jayriihi/WeatherStations/Installation guide/A5F87E7E-C54A-4EF5-8C4A-D947D573DE3A.jpeg

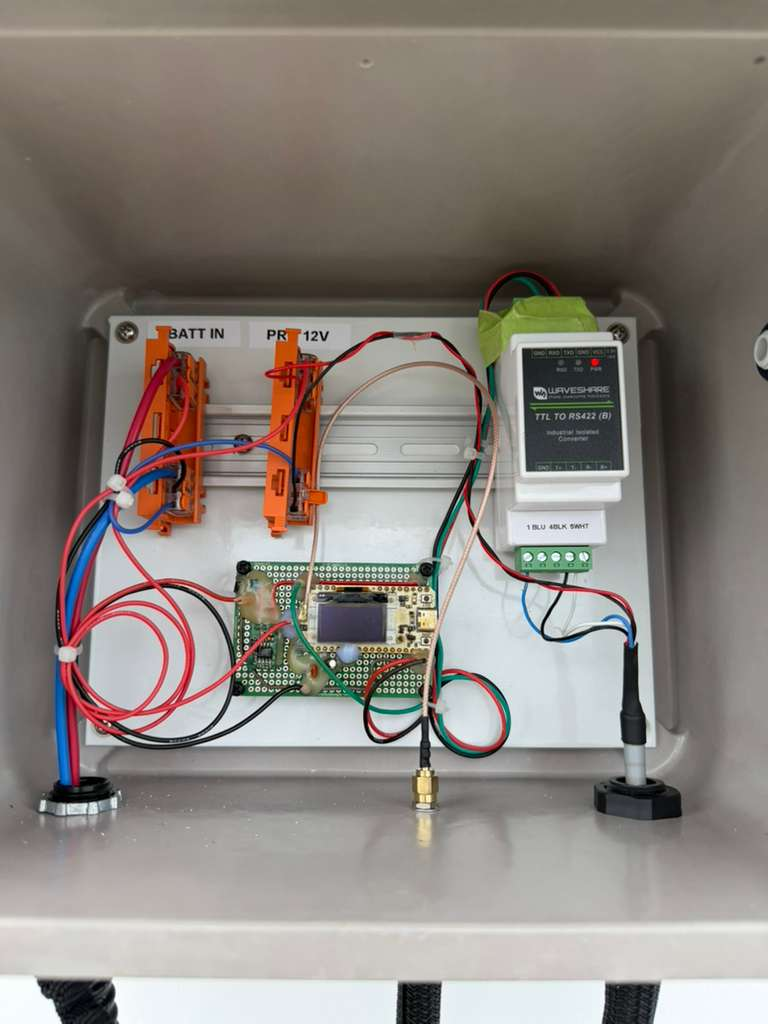
Installation guide/A5F87E7E-C54A-4EF5-8C4A-D947D573DE3A.jpeg
