jayriihi/WeatherStations/Installation guide/C7C500A0-B130-4A4E-9C59-5100DFB371AE_1_105_c.jpeg

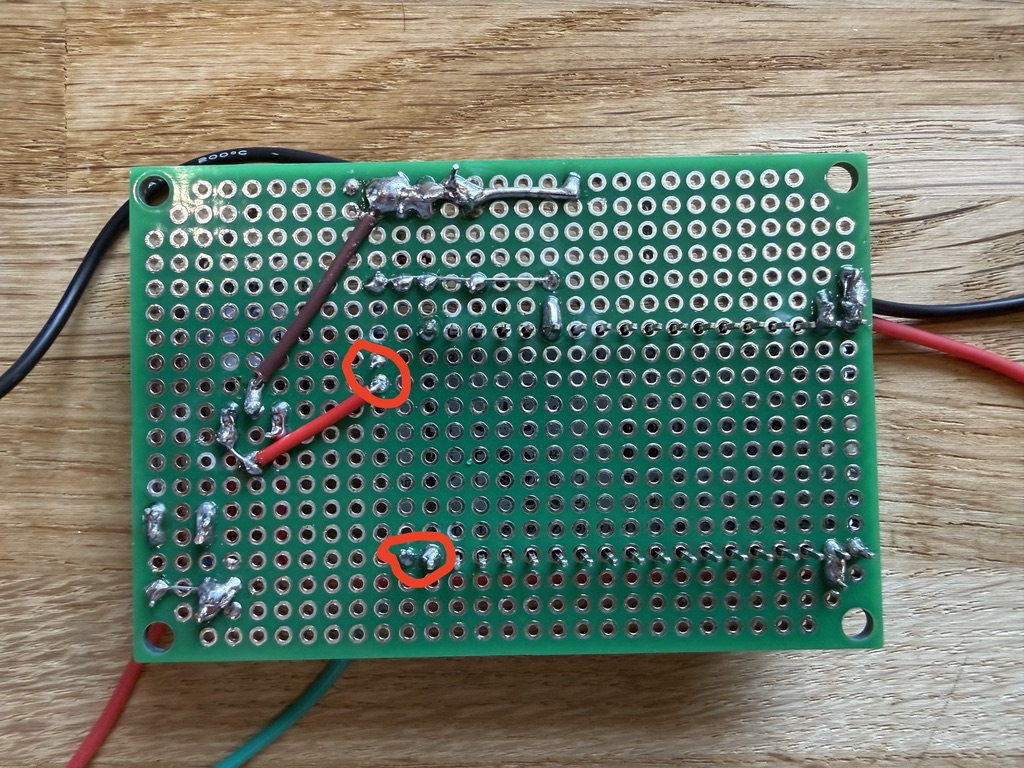
Installation guide/C7C500A0-B130-4A4E-9C59-5100DFB371AE_1_105_c.jpeg
