jayriihi/WeatherStations/Installation guide/0D3FA8E5-6161-42CE-9A30-51A0F75B8781_1_105_c.jpeg

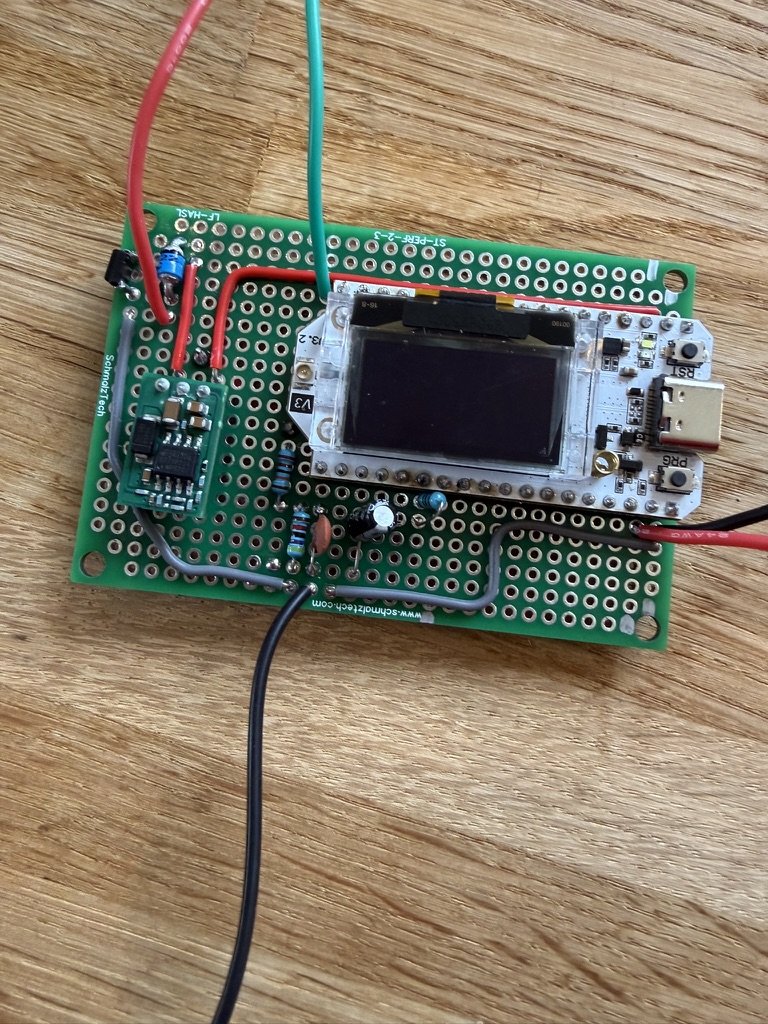
Installation guide/0D3FA8E5-6161-42CE-9A30-51A0F75B8781_1_105_c.jpeg
