jayriihi/WeatherStations/Installation guide/7A51FE77-24B7-4E6C-A224-1E0F3C1EAE3B.jpeg

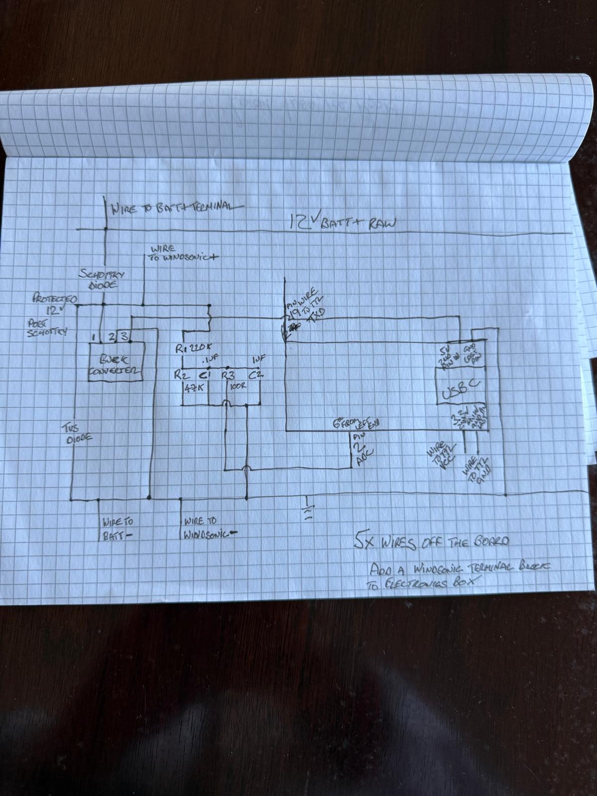
Installation guide/7A51FE77-24B7-4E6C-A224-1E0F3C1EAE3B.jpeg
