jayriihi/WeatherStations/Installation guide/47B4F61A-0BB7-46E7-BAB1-5AC1C1AD3077.jpeg

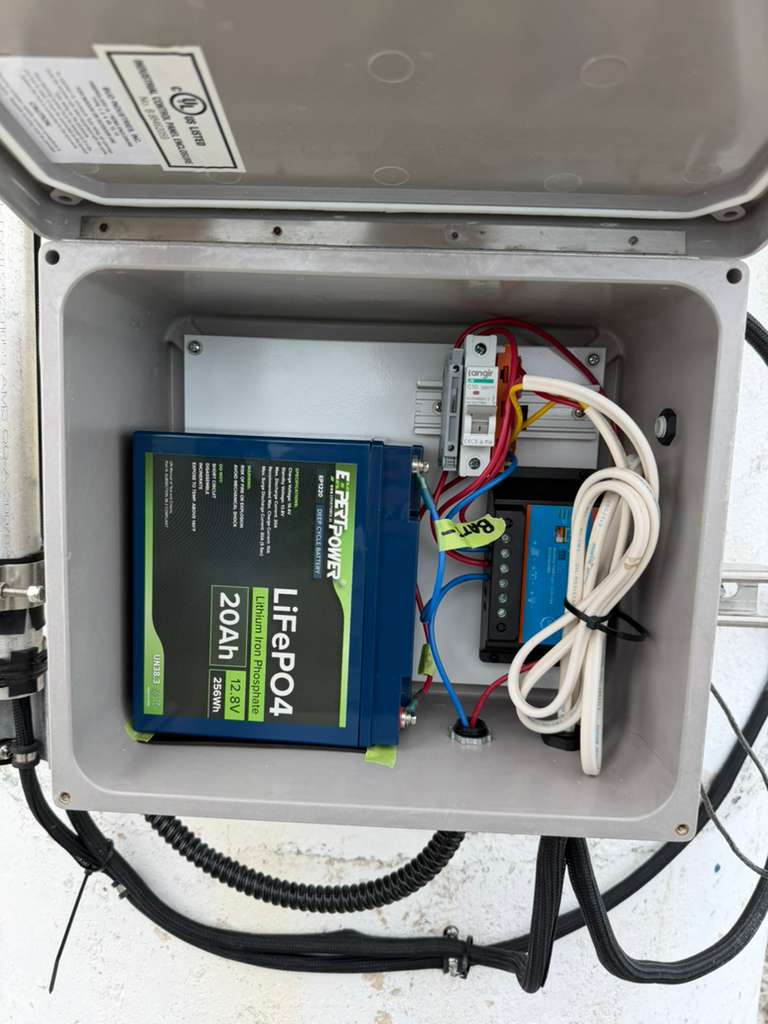
Installation guide/47B4F61A-0BB7-46E7-BAB1-5AC1C1AD3077.jpeg
