jayriihi/WeatherStations/Installation guide/923E344D-D00B-463C-AEA4-50D730EA1828.jpeg

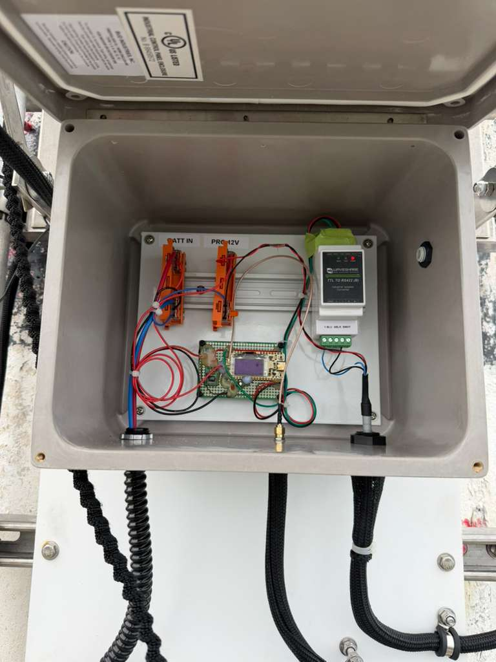
Installation guide/923E344D-D00B-463C-AEA4-50D730EA1828.jpeg
