jayriihi/WeatherStations/Installation guide/858491EE-78B4-45D4-884F-43A59CE96751.jpeg

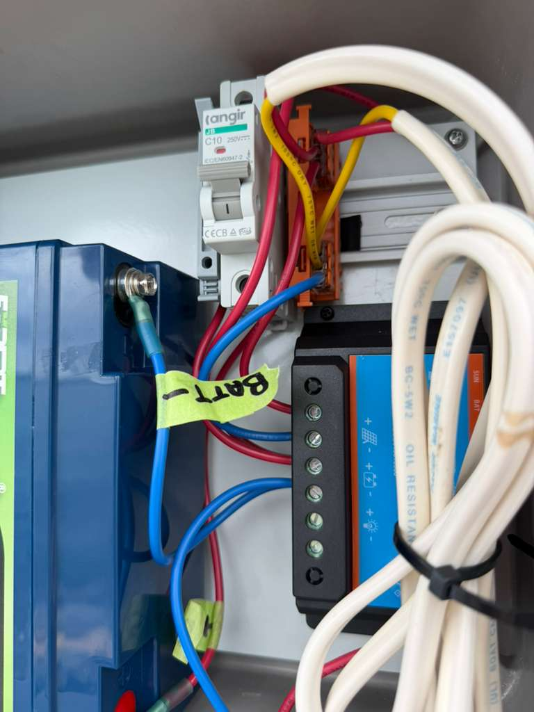
Installation guide/858491EE-78B4-45D4-884F-43A59CE96751.jpeg
