jayriihi/WeatherStations/Installation guide/4281659A-824E-446C-A85B-15BC7FDDD214_1_105_c.jpeg

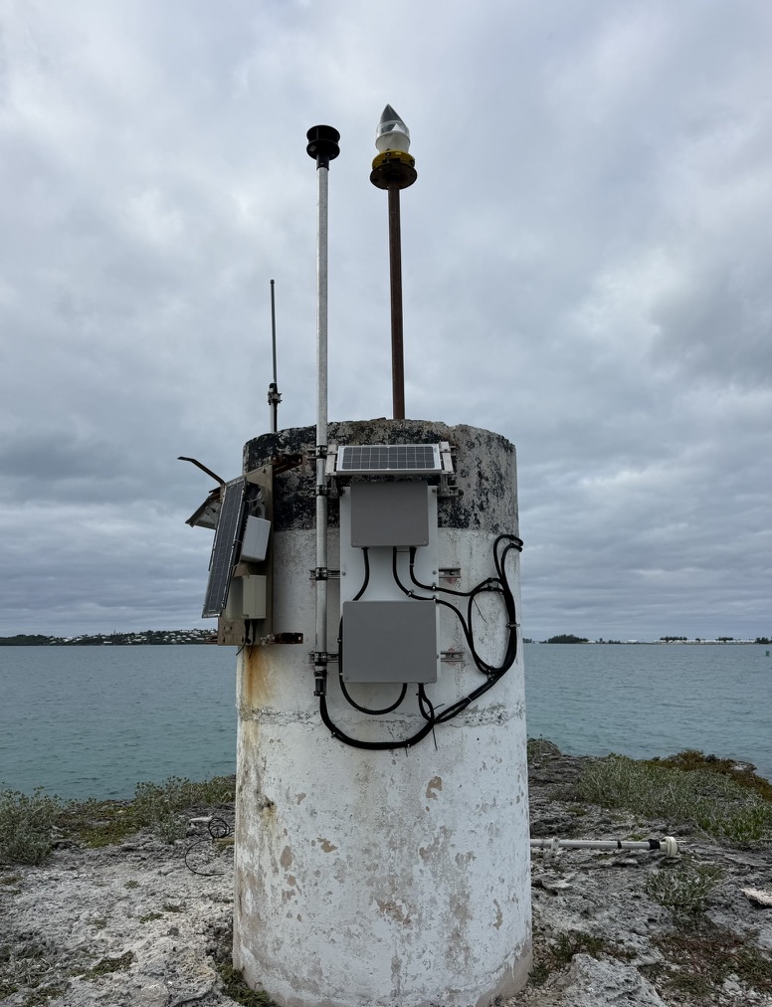
Installation guide/4281659A-824E-446C-A85B-15BC7FDDD214_1_105_c.jpeg
