jayriihi/WeatherStations/Installation guide/D3BEC081-118D-472E-A426-4E98B52E351B_1_105_c.jpeg

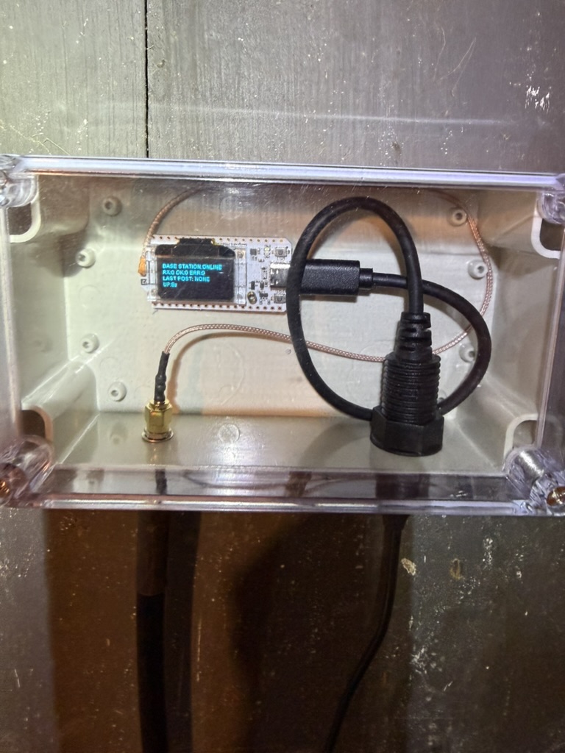
Installation guide/D3BEC081-118D-472E-A426-4E98B52E351B_1_105_c.jpeg
