jayriihi/WeatherStations/Installation guide/DDF8339E-81F4-4CF6-A731-107E2A5637DA_1_105_c.jpeg

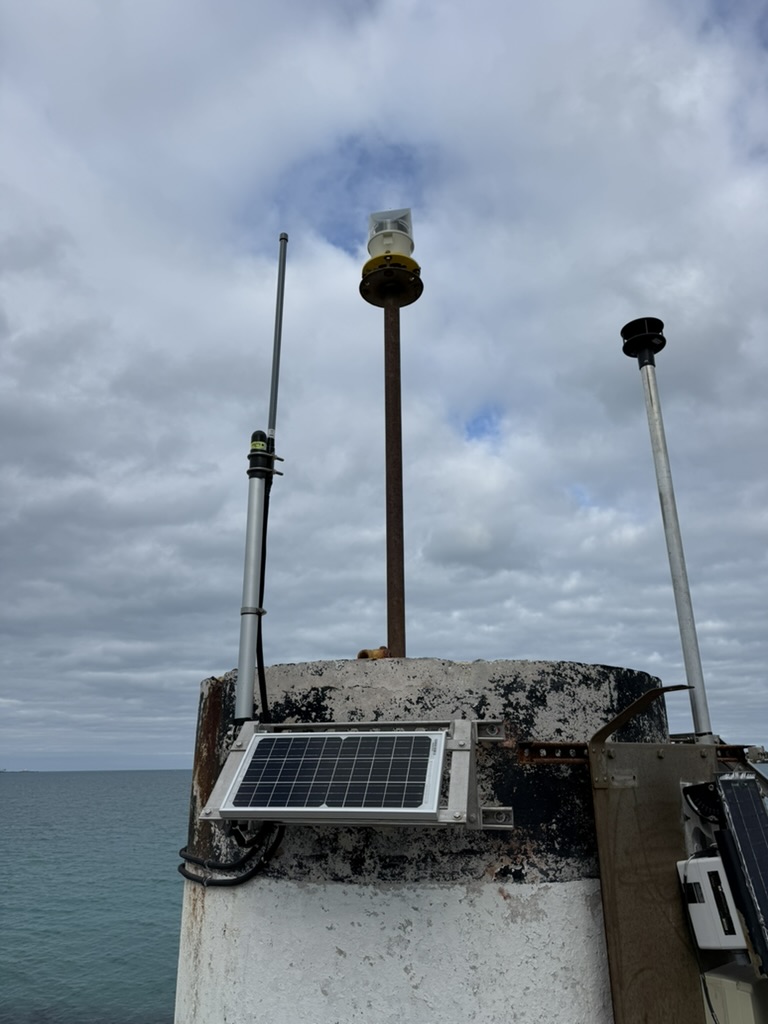
Installation guide/DDF8339E-81F4-4CF6-A731-107E2A5637DA_1_105_c.jpeg
