jayriihi/WeatherStations/Installation guide/FE76AD0C-E634-4722-B1B3-365DB53503B7.jpeg

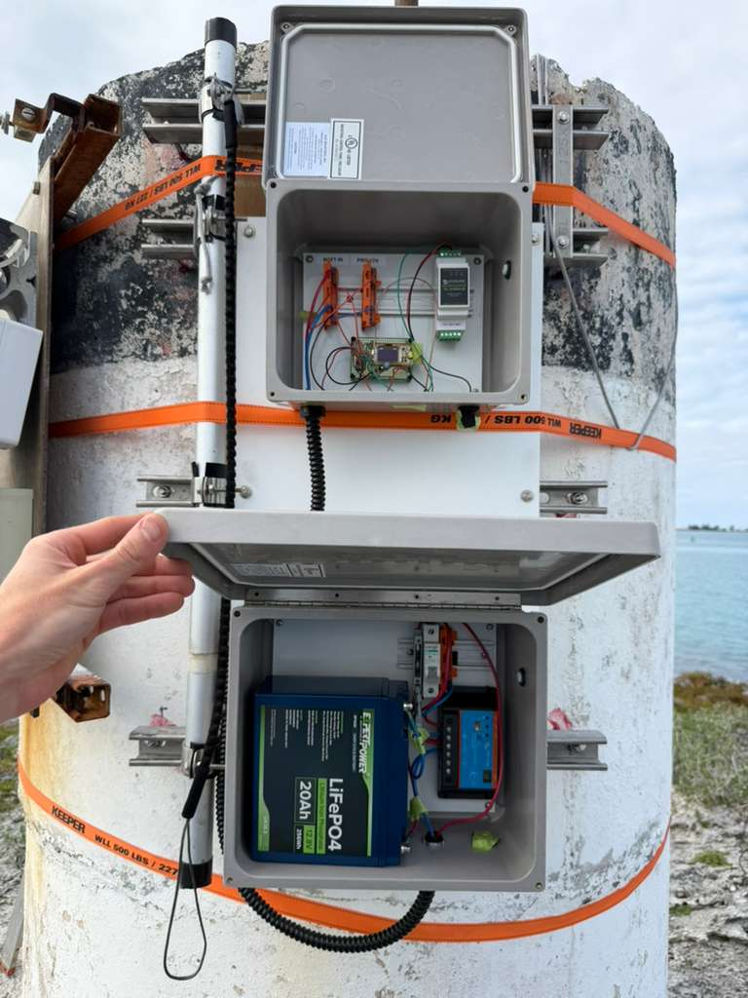
Installation guide/FE76AD0C-E634-4722-B1B3-365DB53503B7.jpeg
