jayriihi/WeatherStations/pearl-station/hardware/pearl-v2-assembly/provisional-layout/pearl_provisional_layout.png

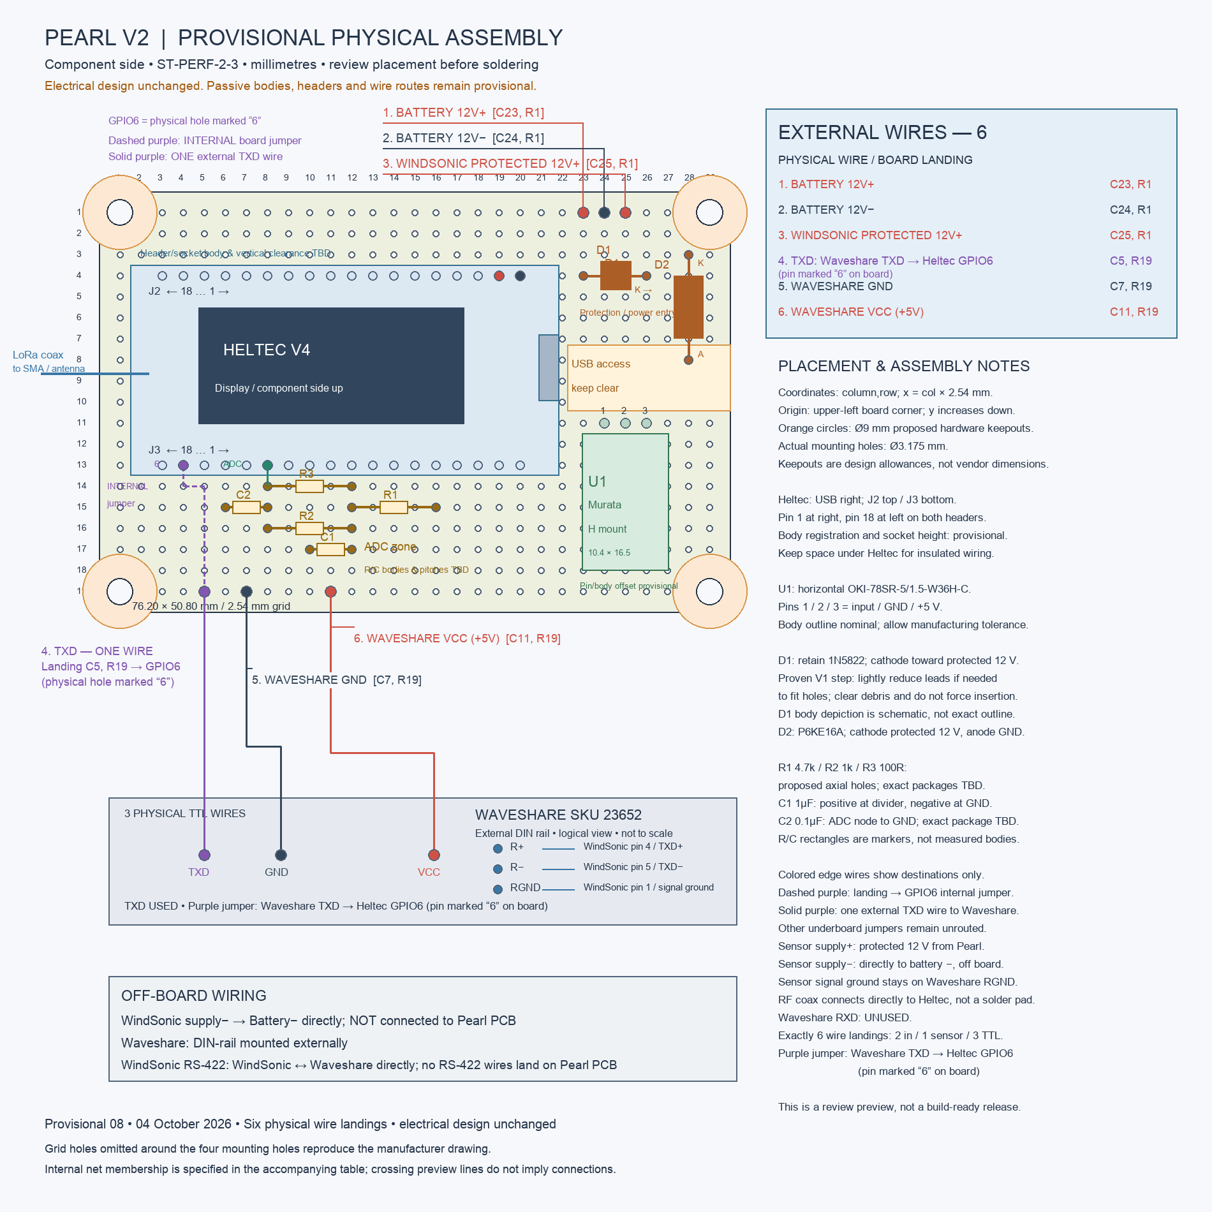
pearl-station/hardware/pearl-v2-assembly/provisional-layout/pearl_provisional_layout.png
