jayriihi/WeatherStations/pearl-station/hardware/pearl-v2-schematic/pearl_v2_final.sch

## KiCad design pearl-station/hardware/pearl-v2-schematic/pearl_v2_final.sch (2026-10-02)

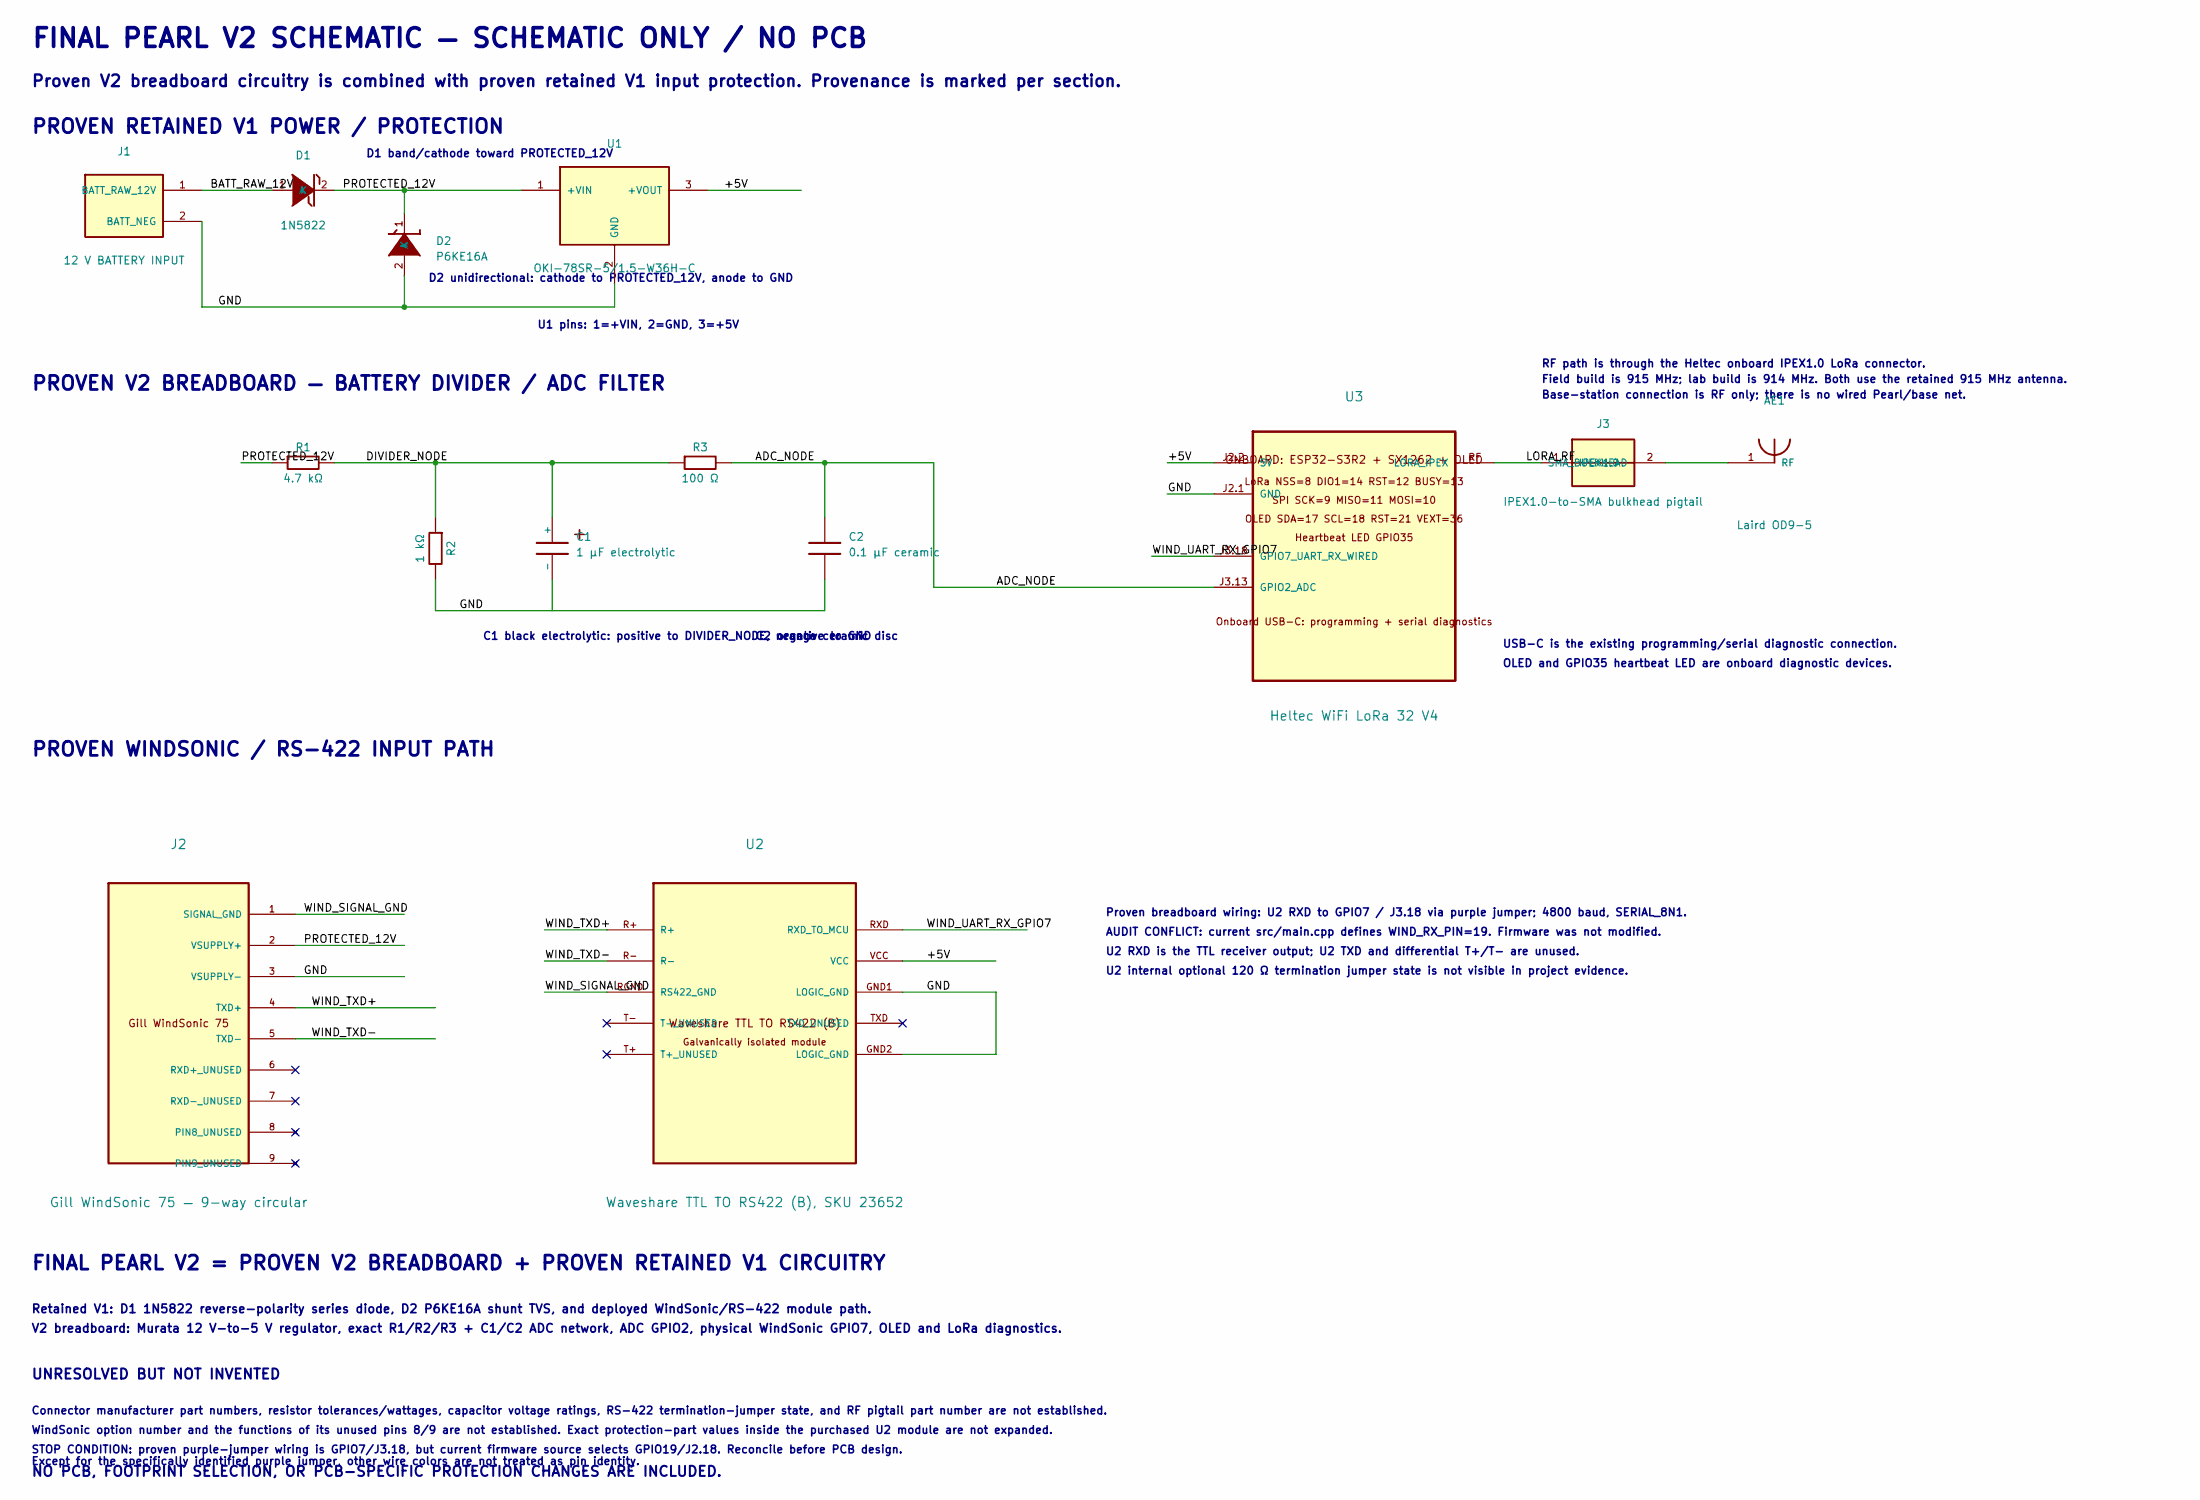
[picture p13: schematic pearl_v2_final.sch]

Parts:
AE1: Laird OD9-5
C1: 1 µF electrolytic
C2: 0.1 µF ceramic
D1: 1N5822
D2: P6KE16A
J1: 12 V BATTERY INPUT
J2: Gill WindSonic 75 — 9-way circular
J3: IPEX1.0-to-SMA bulkhead pigtail
R1: 4.7 kΩ
R2: 1 kΩ
R3: 100 Ω
U1: OKI-78SR-5/1.5-W36H-C
U2: Waveshare TTL TO RS422 (B), SKU 23652
U3: Heltec WiFi LoRa 32 V4

Connections:
+5V: U1.3 (+VOUT), U2.VCC, U3.J2.2 (5V)
ADC_NODE: C2.1, R3.2, U3.J3.13 (GPIO2_ADC)
BATT_RAW_12V: D1.1 (A), J1.1 (BATT_RAW_12V)
DIVIDER_NODE: C1.1 (+), R1.2, R2.1, R3.1
GND: C2.2, D2.2 (A), J1.2 (BATT_NEG), J2.3 (VSUPPLY-), R2.2, U1.2 (GND), U2.GND1 (LOGIC_GND), U2.GND2 (LOGIC_GND), U3.J2.1 (GND)
LORA_RF: J3.1 (IPEX1.0), U3.RF (LORA_IPEX)
unnamed: AE1.1, J3.2 (SMA_BULKHEAD)
PROTECTED_12V: D1.2 (K), D2.1 (K), J2.2 (VSUPPLY+), R1.1, U1.1 (+VIN)
WIND_SIGNAL_GND: J2.1 (SIGNAL_GND), U2.RGND (RS422_GND)
WIND_TXD+: J2.4 (TXD+), U2.R+
WIND_TXD-: J2.5 (TXD-), U2.R-
WIND_UART_RX_GPIO7: U2.RXD (RXD_TO_MCU), U3.J3.18 (GPIO7_UART_RX_WIRED)

Notes on the sheet:
FINAL PEARL V2 SCHEMATIC — SCHEMATIC ONLY / NO PCB
Proven V2 breadboard circuitry is combined with proven retained V1 input protection. Provenance is marked per section.
PROVEN RETAINED V1 POWER / PROTECTION
D1 band/cathode toward PROTECTED_12V
D2 unidirectional: cathode to PROTECTED_12V, anode to GND
U1 pins: 1=+VIN, 2=GND, 3=+5V
PROVEN V2 BREADBOARD — BATTERY DIVIDER / ADC FILTER
C1 black electrolytic: positive to DIVIDER_NODE, negative to GND
C2 orange ceramic disc
USB-C is the existing programming/serial diagnostic connection.
OLED and GPIO35 heartbeat LED are onboard diagnostic devices.
RF path is through the Heltec onboard IPEX1.0 LoRa connector.
Field build is 915 MHz; lab build is 914 MHz. Both use the retained 915 MHz antenna.
Base-station connection is RF only; there is no wired Pearl/base net.
PROVEN WINDSONIC / RS-422 INPUT PATH
Proven breadboard wiring: U2 RXD to GPIO7 / J3.18 via purple jumper; 4800 baud, SERIAL_8N1.
AUDIT CONFLICT: current src/main.cpp defines WIND_RX_PIN=19. Firmware was not modified.
U2 RXD is the TTL receiver output; U2 TXD and differential T+/T- are unused.
U2 internal optional 120 Ω termination jumper state is not visible in project evidence.
FINAL PEARL V2 = PROVEN V2 BREADBOARD + PROVEN RETAINED V1 CIRCUITRY
Retained V1: D1 1N5822 reverse-polarity series diode, D2 P6KE16A shunt TVS, and deployed WindSonic/RS-422 module path.
V2 breadboard: Murata 12 V-to-5 V regulator, exact R1/R2/R3 + C1/C2 ADC network, ADC GPIO2, physical WindSonic GPIO7, OLED and LoRa diagnostics.
UNRESOLVED BUT NOT INVENTED
Connector manufacturer part numbers, resistor tolerances/wattages, capacitor voltage ratings, RS-422 termination-jumper state, and RF pigtail part number are not established.
WindSonic option number and the functions of its unused pins 8/9 are not established. Exact protection-part values inside the purchased U2 module are not expanded.
STOP CONDITION: proven purple-jumper wiring is GPIO7/J3.18, but current firmware source selects GPIO19/J2.18. Reconcile before PCB design.
Except for the specifically identified purple jumper, other wire colors are not treated as pin identity.
NO PCB, FOOTPRINT SELECTION, OR PCB-SPECIFIC PROTECTION CHANGES ARE INCLUDED.
