jayriihi/WeatherStations/base-station/variants/heltec_V4/pins_arduino.h

#ifndef Pins_Arduino_h
#define Pins_Arduino_h

#include <stdint.h>

#ifndef digitalPinToInterrupt
#define digitalPinToInterrupt(p) (p)
#endif

#define USB_VID 0x303a
#define USB_PID 0x1001

static const uint8_t LED_BUILTIN = 35;
#define BUILTIN_LED LED_BUILTIN
#define LED_BUILTIN LED_BUILTIN

static const uint8_t TX = 43;
static const uint8_t RX = 44;

static const uint8_t SDA = 4;
static const uint8_t SCL = 3;

static const uint8_t SS = 8;
static const uint8_t MOSI = 10;
static const uint8_t MISO = 11;
static const uint8_t SCK = 9;

static const uint8_t A0 = 1;
static const uint8_t A1 = 2;
static const uint8_t A2 = 3;
static const uint8_t A3 = 4;
static const uint8_t A4 = 5;
static const uint8_t A5 = 6;
static const uint8_t A6 = 7;
static const uint8_t A7 = 8;
static const uint8_t A8 = 9;
static const uint8_t A9 = 10;
static const uint8_t A10 = 11;
static const uint8_t A11 = 12;
static const uint8_t A12 = 13;
static const uint8_t A13 = 14;
static const uint8_t A14 = 15;
static const uint8_t A15 = 16;
static const uint8_t A16 = 17;
static const uint8_t A17 = 18;
static const uint8_t A18 = 19;
static const uint8_t A19 = 20;

static const uint8_t T1 = 1;
static const uint8_t T2 = 2;
static const uint8_t T3 = 3;
static const uint8_t T4 = 4;
static const uint8_t T5 = 5;
static const uint8_t T6 = 6;
static const uint8_t T7 = 7;
static const uint8_t T8 = 8;
static const uint8_t T9 = 9;
static const uint8_t T10 = 10;
static const uint8_t T11 = 11;
static const uint8_t T12 = 12;
static const uint8_t T13 = 13;
static const uint8_t T14 = 14;

static const uint8_t Vext = 36;
static const uint8_t LED = 35;
static const uint8_t RST_OLED = 21;
static const uint8_t SCL_OLED = 18;
static const uint8_t SDA_OLED = 17;

static const uint8_t RST_LoRa = 12;
static const uint8_t BUSY_LoRa = 13;
static const uint8_t DIO0 = 14;

#endif /* Pins_Arduino_h */
