jayriihi/WeatherStations/base-station/src/main.cpp

/*
  Build-time configuration:

  - Select env in PlatformIO:
      base_field / base_lab
      pearl_field / pearl_lab

  - Macros:
      ENV_LAB / ENV_FIELD   : which environment is built
      LAB_MODE              : base-station only, selects test vs prod Apps Script
      LORA_FREQ             : LoRa center frequency (Hz)
      LORA_TX_POWER         : LoRa TX power (dBm)
      POST_BASE             : Google Apps Script endpoint (base-station only)
      API_KEY               : shared API key for Apps Script (base-station only)

  LAB builds:
    - Define ENV_LAB (both Pearl + Base)
    - Define LAB_MODE (Base only)
    - 914 MHz, low TX power (2 dBm)
    - Base posts to TEST sheet script URL

  FIELD builds:
    - Define ENV_FIELD
    - Do NOT define LAB_MODE
    - 915 MHz, normal TX power (14 dBm)
    - Base posts to PROD 'Pearl' sheet script URL
*/

#include <Arduino.h>
#include <SPI.h>
#include <RadioLib.h>
#include <WiFi.h>
#include <WiFiClientSecure.h>
#include <HTTPClient.h>
#include <ArduinoJson.h>
#include <LittleFS.h>
#include <time.h>
#include <ctype.h>
#include <string.h>
#include <limits.h>
#include <vector>
#include "Config.h"

#ifdef HAS_DISPLAY
#include "DisplayUI.h"
#endif

// ---------- Google Apps Script endpoint + API key ----------
#ifdef LAB_MODE
  // LAB: writes to 'test' tab
  #define POST_BASE "https://script.google.com/macros/s/AKfycbw04W7Gro8RZLqBTO1T64v_6ii_u_Sa5rm2CY-NmL3s-tl4hnEIZXStDCfbS3oVdJ5kTg/exec"
#else
  // PROD: writes to 'Pearl' tab
  #define POST_BASE "https://script.google.com/macros/s/AKfycbxkcVc6BP2oJtQcAB8cAvWWrIU9eDIGanyI5yWVj7GwHgISrCKnozDGZMXJobOxHGFu/exec"
#endif

#define API_KEY "jI6nrJ2KTsgK0SDu"

// === CRC16 APP-LAYER ===
static uint16_t crc16_ccitt(const uint8_t* data, size_t len, uint16_t crc = 0xFFFF) {
  for (size_t i = 0; i < len; ++i) {
    crc ^= (uint16_t)data[i] << 8;
    for (int b = 0; b < 8; ++b) {
      crc = (crc & 0x8000) ? (uint16_t)((crc << 1) ^ 0x1021) : (uint16_t)(crc << 1);
    }
  }
  return crc;
}

// === LEDS ===
// Heltec V3 usually exposes an onboard LED via LED_BUILTIN.
// If not defined by the core, fall back to GPIO 35.

// === LED ===
// Onboard white LED on GPIO 35
static const int LED_HEARTBEAT = 35;

static uint32_t g_rxHoldUntilMs = 0;


// ---------- Wi-Fi ----------
static void connectWiFi(uint32_t maxWaitMs = 15000) {
  // List of networks to try, in order of preference
  const char* SSIDS[] = {
    "Hapenny",
    "Spankys House",
    "Jaysphone",
  };
  const char* PASSES[] = {
    "hapennyhouse",
    "131Glenmont",
    "Riihiluoma",
  };
  const int WIFI_COUNT = sizeof(SSIDS) / sizeof(SSIDS[0]);

  if (WiFi.status() == WL_CONNECTED) return;

  WiFi.mode(WIFI_STA);

  // Split the total wait time across all networks
  uint32_t perNetWait = (WIFI_COUNT > 0) ? maxWaitMs / WIFI_COUNT : maxWaitMs;
  if (perNetWait < 2000) perNetWait = 3000;  // don't bother with super tiny timeouts

  for (int i = 0; i < WIFI_COUNT; ++i) {
    Serial.printf("WiFi: trying SSID '%s'\n", SSIDS[i]);
    WiFi.begin(SSIDS[i], PASSES[i]);

    uint32_t t0 = millis();
    while (WiFi.status() != WL_CONNECTED && (millis() - t0) < perNetWait) {
      delay(250);
      Serial.print(".");
    }

    if (WiFi.status() == WL_CONNECTED) {
      Serial.printf("\nWiFi OK ssid=%s ip=%s\n",
                    SSIDS[i],
                    WiFi.localIP().toString().c_str());
      return;
    }

    Serial.println("\nWiFi: failed on this SSID, trying next");
    WiFi.disconnect(true, true);
    delay(200);
  }

  Serial.println("WiFi: not connected to any configured network, continuing offline");
}



// Health counters
static uint32_t g_crc_ok   = 0;
static uint32_t g_crc_fail = 0;
static uint32_t g_rf_dup   = 0;
static uint32_t g_boot_id  = (uint32_t)esp_random();
static uint32_t g_start_ms = 0;

// Heltec WiFi LoRa 32 V3 (SX1262) pins
static const int PIN_NSS  = 8;
static const int PIN_DIO1 = 14;
static const int PIN_RST  = 12;
static const int PIN_BUSY = 13;
static const int PIN_SCK  = 9;
static const int PIN_MISO = 11;
static const int PIN_MOSI = 10;

// RADIO & GLOBALS
Module* modPtr = nullptr;
SX1262* lora   = nullptr;

static int32_t  g_lastCntPosted = -1;
static String   g_lastRx;
static uint32_t g_lastRxMs = 0;
static String   g_lastBody;
static uint32_t g_lastPostMs = 0;

static uint16_t g_dupCount   = 0;
static uint32_t g_dupLastLog = 0;

static const uint32_t MIN_POST_MS = 20000UL;
static int32_t  g_inflightCnt = -1;
static uint32_t g_inflightMs  = 0;
static const uint32_t INFLIGHT_GUARD_MS = 5000UL;

// Drop/miss tracking (per-packet seq cnt)
static int32_t  g_lastCntAccepted  = -1;
static uint32_t g_drop_total       = 0;
static uint32_t g_delivered_total  = 0;
static int32_t  g_latestCntReceived = -1;

// Local buffering (A/B rollover)
static const char* BUF_A_PATH = "/buffer_A.log";
static const char* BUF_B_PATH = "/buffer_B.log";
static const char* BUF_STATE_PATH = "/buffer_state.json";
#ifdef LAB_MODE
static const size_t BUF_MAX_BYTES = 8UL * 1024UL;
#else
static const size_t BUF_MAX_BYTES = 256UL * 1024UL;
#endif

static bool g_bufferEnabled = false;
static char g_activeBuf = 'A';
static int32_t g_lastUploadedCnt = -1;
static String g_serialCmdLine;

static void resetRadioForRx();

static const char* activeBufferPath() {
  return (g_activeBuf == 'B') ? BUF_B_PATH : BUF_A_PATH;
}

static const char* otherBufferPath() {
  return (g_activeBuf == 'B') ? BUF_A_PATH : BUF_B_PATH;
}

static bool parseCntFromLine(const String& line, int32_t& outCnt) {
  StaticJsonDocument<256> doc;
  DeserializationError err = deserializeJson(doc, line);
  if (err || !doc["cnt"].is<int32_t>()) return false;
  outCnt = doc["cnt"].as<int32_t>();
  return true;
}

static size_t fileSizeOf(const char* path) {
  File f = LittleFS.open(path, "r");
  if (!f) return 0;
  size_t n = (size_t)f.size();
  f.close();
  return n;
}

static int32_t scanMaxCnt(const char* path) {
  File f = LittleFS.open(path, "r");
  if (!f) return -1;
  int32_t maxCnt = -1;
  while (f.available()) {
    String line = f.readStringUntil('\n');
    int32_t cnt = -1;
    if (parseCntFromLine(line, cnt) && cnt > maxCnt) maxCnt = cnt;
  }
  f.close();
  return maxCnt;
}

static bool saveState() {
  if (!g_bufferEnabled) return false;
  StaticJsonDocument<96> doc;
  doc["active"] = (g_activeBuf == 'B') ? "B" : "A";
  doc["last_uploaded_cnt"] = g_lastUploadedCnt;

  File f = LittleFS.open(BUF_STATE_PATH, "w");
  if (!f) {
    Serial.println("BUFFER: saveState open failed");
    return false;
  }
  serializeJson(doc, f);
  f.close();
  return true;
}

static bool loadState() {
  if (!g_bufferEnabled) return false;
  if (!LittleFS.exists(BUF_STATE_PATH)) return false;
  File f = LittleFS.open(BUF_STATE_PATH, "r");
  if (!f) return false;

  StaticJsonDocument<128> doc;
  DeserializationError err = deserializeJson(doc, f);
  f.close();
  if (err) return false;

  const char* active = doc["active"] | "";
  if (active[0] != 'A' && active[0] != 'B') return false;

  g_activeBuf = active[0];
  g_lastUploadedCnt = doc["last_uploaded_cnt"] | -1;
  return true;
}

static void initBufferState() {
  if (!g_bufferEnabled) return;
  if (loadState()) {
    Serial.printf("BUFFER: state loaded active=%c last_uploaded_cnt=%ld\n",
                  g_activeBuf, (long)g_lastUploadedCnt);
  } else {
    int32_t maxA = scanMaxCnt(BUF_A_PATH);
    int32_t maxB = scanMaxCnt(BUF_B_PATH);
    if (maxA < 0 && maxB < 0) {
      g_activeBuf = 'A';
    } else {
      g_activeBuf = (maxB > maxA) ? 'B' : 'A';
    }
    g_lastUploadedCnt = -1;
    saveState();
    Serial.printf("BUFFER: state recovered active=%c (maxA=%ld maxB=%ld)\n",
                  g_activeBuf, (long)maxA, (long)maxB);
  }

  if (!LittleFS.exists(BUF_A_PATH)) {
    File fa = LittleFS.open(BUF_A_PATH, "w");
    if (fa) fa.close();
  }
  if (!LittleFS.exists(BUF_B_PATH)) {
    File fb = LittleFS.open(BUF_B_PATH, "w");
    if (fb) fb.close();
  }

  File f = LittleFS.open(activeBufferPath(), "a");
  if (f) f.close();
}

static void setLastUploadedCnt(int32_t cnt) {
  if (!g_bufferEnabled || cnt < 0) return;
  if (g_lastUploadedCnt == cnt) return;
  g_lastUploadedCnt = cnt;
  saveState();
}

static bool appendBufferedLine(const String& line) {
  if (!g_bufferEnabled) return false;

  const char* activePath = activeBufferPath();
  File f = LittleFS.open(activePath, "a");
  if (!f) {
    Serial.printf("BUFFER: append open failed (%s)\n", activePath);
    return false;
  }

  size_t w1 = f.print(line);
  size_t w2 = f.print('\n');
  size_t newSize = (size_t)f.size();
  f.close();
  if (w1 != line.length() || w2 != 1) {
    Serial.printf("BUFFER: short write (%s)\n", activePath);
  }

  if (newSize > BUF_MAX_BYTES) {
    char nextBuf = (g_activeBuf == 'A') ? 'B' : 'A';
    const char* nextPath = (nextBuf == 'A') ? BUF_A_PATH : BUF_B_PATH;
    File clearFile = LittleFS.open(nextPath, "w");
    if (!clearFile) {
      Serial.printf("BUFFER: rollover clear failed (%s)\n", nextPath);
      return true;
    }
    clearFile.close();

    g_activeBuf = nextBuf;
    saveState();
    Serial.printf("BUFFER: rollover -> %c (cleared %s)\n", g_activeBuf, nextPath);
  }

  return true;
}

static void appendBufferRecord(float wind_avg,
                               float wind_max,
                               int wind_dir,
                               int32_t cnt,
                               float batt_v,
                               float rssi_f,
                               float snr_f,
                               uint32_t uptime_s) {
  if (!g_bufferEnabled) return;

  StaticJsonDocument<256> doc;
  time_t now = time(nullptr);
  if (now > 1600000000) {
    doc["ts"] = (uint32_t)now;
  } else {
    doc["ts"] = nullptr;
  }
  doc["spd"] = wind_avg;
  doc["max"] = wind_max;
  doc["dir"] = wind_dir;
  doc["cnt"] = cnt;
  doc["bat"] = batt_v;
  doc["rssi"] = rssi_f;
  doc["snr"] = snr_f;
  doc["crc_ok"] = g_crc_ok;
  doc["crc_fail"] = g_crc_fail;
  doc["rf_dup"] = g_rf_dup;
  doc["upt"] = uptime_s;

  String line;
  line.reserve(196);
  serializeJson(doc, line);
  appendBufferedLine(line);
}

static void dumpFile(const char* path, int32_t startCnt, int32_t endCnt) {
  File f = LittleFS.open(path, "r");
  if (!f) {
    Serial.printf("DUMP: cannot open %s\n", path);
    return;
  }

  bool havePending = false;
  int32_t pendingCnt = -1;
  String pendingLine;

  while (f.available()) {
    String line = f.readStringUntil('\n');
    int32_t cnt = -1;
    if (!parseCntFromLine(line, cnt)) continue;
    if (cnt < startCnt || cnt > endCnt) continue;

    if (!havePending) {
      pendingCnt = cnt;
      pendingLine = line;
      havePending = true;
      continue;
    }
    if (cnt == pendingCnt) {
      pendingLine = line;  // keep the last duplicate cnt
      continue;
    }

    Serial.println(pendingLine);
    pendingCnt = cnt;
    pendingLine = line;
  }
  if (havePending) Serial.println(pendingLine);
  f.close();
}

static void selectBufferOrder(const char*& older, const char*& newer) {
  older = BUF_A_PATH;
  newer = BUF_B_PATH;

  int32_t maxA = scanMaxCnt(BUF_A_PATH);
  int32_t maxB = scanMaxCnt(BUF_B_PATH);
  if (maxA < 0 && maxB < 0) {
    older = nullptr;
    newer = nullptr;
  } else if (maxA < 0) {
    older = BUF_B_PATH;
    newer = BUF_B_PATH;
  } else if (maxB < 0) {
    older = BUF_A_PATH;
    newer = BUF_A_PATH;
  } else if (maxA > maxB) {
    older = BUF_B_PATH;
    newer = BUF_A_PATH;
  }
}

static void dumpRecordsInOrder(int32_t startCnt, int32_t endCnt) {
  if (!g_bufferEnabled) {
    Serial.println("DUMP: buffering disabled");
    return;
  }

  const char* older = nullptr;
  const char* newer = nullptr;
  selectBufferOrder(older, newer);
  if (!older || !newer) {
    Serial.println("DUMP: no records");
    return;
  }

  Serial.printf("DUMP: older=%s newer=%s\n", older, newer);
  dumpFile(older, startCnt, endCnt);
  if (older != newer) dumpFile(newer, startCnt, endCnt);
}

static bool parseCsvRecordLine(const String& line, StaticJsonDocument<256>& doc, int32_t& cntOut) {
  DeserializationError err = deserializeJson(doc, line);
  if (err || !doc["cnt"].is<int32_t>()) return false;
  cntOut = doc["cnt"].as<int32_t>();
  return true;
}

static bool buildCsvRowFromJson(const String& line, String& rowOut) {
  StaticJsonDocument<256> doc;
  int32_t cnt = -1;
  if (!parseCsvRecordLine(line, doc, cnt)) return false;

  rowOut = "";
  rowOut.reserve(128);
  if (doc["ts"].isNull()) {
    rowOut += "";
  } else if (doc["ts"].is<const char*>()) {
    rowOut += doc["ts"].as<const char*>();
  } else {
    rowOut += String((long)doc["ts"].as<int32_t>());
  }
  rowOut += ",";
  rowOut += String(doc["spd"] | 0.0f, 2);
  rowOut += ",";
  rowOut += String(doc["max"] | 0.0f, 2);
  rowOut += ",";
  rowOut += String(doc["dir"] | 0);
  rowOut += ",";
  rowOut += String((long)cnt);
  rowOut += ",";
  rowOut += String(doc["bat"] | 0.0f, 2);
  rowOut += ",";
  rowOut += String(doc["rssi"] | 0.0f, 2);
  rowOut += ",";
  rowOut += String(doc["snr"] | 0.0f, 2);
  rowOut += ",";
  rowOut += String((unsigned long)(doc["crc_ok"] | 0UL));
  rowOut += ",";
  rowOut += String((unsigned long)(doc["crc_fail"] | 0UL));
  rowOut += ",";
  rowOut += String((unsigned long)(doc["rf_dup"] | 0UL));
  rowOut += ",";
  rowOut += String((unsigned long)(doc["upt"] | 0UL));
  return true;
}

static void flushPendingCsv(std::vector<String>& rows, bool& havePending, String& pendingLine) {
  if (!havePending) return;
  String csvRow;
  if (buildCsvRowFromJson(pendingLine, csvRow)) rows.push_back(csvRow);
  havePending = false;
  pendingLine = "";
}

static void collectFileCsv(const char* path,
                           int32_t startCnt,
                           int32_t endCnt,
                           std::vector<String>& rows,
                           bool& havePending,
                           int32_t& pendingCnt,
                           String& pendingLine) {
  File f = LittleFS.open(path, "r");
  if (!f) {
    Serial.printf("DUMP CSV: cannot open %s\n", path);
    return;
  }

  while (f.available()) {
    String line = f.readStringUntil('\n');
    StaticJsonDocument<256> doc;
    int32_t cnt = -1;
    if (!parseCsvRecordLine(line, doc, cnt)) continue;
    if (cnt < startCnt || cnt > endCnt) continue;

    if (!havePending) {
      pendingCnt = cnt;
      pendingLine = line;
      havePending = true;
      continue;
    }
    if (cnt == pendingCnt) {
      pendingLine = line;  // keep the last duplicate cnt
      continue;
    }

    flushPendingCsv(rows, havePending, pendingLine);
    pendingCnt = cnt;
    pendingLine = line;
    havePending = true;
  }
  f.close();
}

static void dumpCsvInOrder(int32_t startCnt, int32_t endCnt) {
  if (!g_bufferEnabled) {
    Serial.println("DUMP: buffering disabled");
    return;
  }

  const char* older = nullptr;
  const char* newer = nullptr;
  selectBufferOrder(older, newer);
  if (!older || !newer) {
    Serial.println("DUMP: no records");
    return;
  }

  std::vector<String> rows;
  bool havePending = false;
  int32_t pendingCnt = -1;
  String pendingLine;

  collectFileCsv(older, startCnt, endCnt, rows, havePending, pendingCnt, pendingLine);
  if (older != newer) collectFileCsv(newer, startCnt, endCnt, rows, havePending, pendingCnt, pendingLine);
  flushPendingCsv(rows, havePending, pendingLine);

  Serial.println("ts,spd,max,dir,cnt,bat,rssi,snr,crc_ok,crc_fail,rf_dup,upt");
  for (int i = (int)rows.size() - 1; i >= 0; --i) {
    Serial.println(rows[(size_t)i]);
  }
}

static void printBufferStatus() {
  if (!g_bufferEnabled) {
    Serial.println("BUFFER: enabled=no");
    return;
  }

  int32_t maxA = scanMaxCnt(BUF_A_PATH);
  int32_t maxB = scanMaxCnt(BUF_B_PATH);
  size_t sizeA = fileSizeOf(BUF_A_PATH);
  size_t sizeB = fileSizeOf(BUF_B_PATH);
  Serial.println("BUFFER: enabled=yes");
  Serial.printf("BUFFER: active=%c path=%s\n", g_activeBuf, activeBufferPath());
  Serial.printf("BUFFER: size_A=%u size_B=%u limit=%u\n",
                (unsigned)sizeA, (unsigned)sizeB, (unsigned)BUF_MAX_BYTES);
  Serial.printf("BUFFER: max_cnt_A=%ld max_cnt_B=%ld\n", (long)maxA, (long)maxB);
  Serial.printf("BUFFER: last_uploaded_cnt=%ld latest_cnt_received=%ld\n",
                (long)g_lastUploadedCnt, (long)g_latestCntReceived);
}

static void runDumpAllCommand() {
  Serial.println("DUMP ALL: begin");
  dumpRecordsInOrder(INT32_MIN, INT32_MAX);
  Serial.println("DUMP ALL: end");
}

static void runDumpCntCommand(int32_t startCnt, int32_t endCnt) {
  Serial.printf("DUMP CNT: begin [%ld..%ld]\n", (long)startCnt, (long)endCnt);
  dumpRecordsInOrder(startCnt, endCnt);
  Serial.println("DUMP CNT: end");
}

static void runDumpCsvAll() {
  Serial.println("DUMP CSV: begin");
  dumpCsvInOrder(INT32_MIN, INT32_MAX);
  Serial.println("DUMP CSV: end");
}

static void runDumpCsvRange(int32_t startCnt, int32_t endCnt) {
  Serial.printf("DUMP CSV: begin [%ld..%ld]\n", (long)startCnt, (long)endCnt);
  dumpCsvInOrder(startCnt, endCnt);
  Serial.println("DUMP CSV: end");
}

static void printHelp() {
  Serial.println("Commands:");
  Serial.println("  STATUS");
  Serial.println("  DUMP ALL");
  Serial.println("  DUMP CNT <start> <end>");
  Serial.println("  DUMP CSV");
  Serial.println("  DUMP CSV <start> <end>");
}

#ifdef LAB_MODE
static void runInjectCommand(int32_t count) {
  if (!g_bufferEnabled) {
    Serial.println("INJECT: buffering disabled");
    return;
  }
  if (count <= 0) {
    Serial.println("INJECT: n must be > 0");
    return;
  }

  int32_t maxA = scanMaxCnt(BUF_A_PATH);
  int32_t maxB = scanMaxCnt(BUF_B_PATH);
  int32_t cnt = ((maxA > maxB) ? maxA : maxB) + 1;
  if (cnt < 0) cnt = 0;

  for (int32_t i = 0; i < count; ++i) {
    float wind_avg = 5.0f + (float)((i % 25) * 0.4f);
    float wind_max = wind_avg + 2.5f;
    int wind_dir = (int)((cnt * 7) % 360);
    float batt_v = 4.10f - (float)(i % 10) * 0.01f;
    float rssi_f = -95.0f + (float)(i % 9);
    float snr_f = -2.0f + (float)(i % 6) * 0.5f;
    uint32_t uptime_s = (millis() - g_start_ms) / 1000UL;
    appendBufferRecord(wind_avg, wind_max, wind_dir, cnt, batt_v, rssi_f, snr_f, uptime_s);
    g_latestCntReceived = cnt;
    cnt++;
  }

  Serial.printf("INJECT: wrote %ld records\n", (long)count);
}
#endif

static void handleSerialCommand(const String& line) {
  String cmd = line;
  cmd.trim();
  if (cmd.length() == 0) return;

  String u = cmd;
  u.toUpperCase();

  if (u == "HELP" || u == "?") {
    printHelp();
    return;
  }
  if (u == "STATUS") {
    printBufferStatus();
    return;
  }
  if (u == "DUMP ALL" || u == "DUMPALL") {
    runDumpAllCommand();
    return;
  }
  if (u == "DUMP CSV" || u == "DUMPCSV") {
    runDumpCsvAll();
    return;
  }
  if (u.startsWith("DUMP CSV ") || u.startsWith("DUMPCSV ")) {
    long startCnt = 0;
    long endCnt = 0;
    int matched = 0;
    if (u.startsWith("DUMP CSV ")) {
      matched = sscanf(u.c_str(), "DUMP CSV %ld %ld", &startCnt, &endCnt);
    } else {
      matched = sscanf(u.c_str(), "DUMPCSV %ld %ld", &startCnt, &endCnt);
    }
    if (matched != 2) {
      Serial.println("CMD: usage DUMP CSV <start> <end>");
      return;
    }
    if (startCnt > endCnt) {
      Serial.println("CMD: start must be <= end");
      return;
    }
    runDumpCsvRange((int32_t)startCnt, (int32_t)endCnt);
    return;
  }
  if (u.startsWith("DUMP CNT ") || u.startsWith("DUMPCNT ")) {
    long startCnt = 0;
    long endCnt = 0;
    int matched = 0;
    if (u.startsWith("DUMP CNT ")) {
      matched = sscanf(u.c_str(), "DUMP CNT %ld %ld", &startCnt, &endCnt);
    } else {
      matched = sscanf(u.c_str(), "DUMPCNT %ld %ld", &startCnt, &endCnt);
    }
    if (matched != 2) {
      Serial.println("CMD: usage DUMP CNT <start> <end>");
      return;
    }
    if (startCnt > endCnt) {
      Serial.println("CMD: start must be <= end");
      return;
    }
    runDumpCntCommand((int32_t)startCnt, (int32_t)endCnt);
    return;
  }
#ifdef LAB_MODE
  if (u.startsWith("INJECT ")) {
    long n = 0;
    if (sscanf(u.c_str(), "INJECT %ld", &n) != 1) {
      Serial.println("CMD: usage INJECT <n>");
      return;
    }
    runInjectCommand((int32_t)n);
    return;
  }
#endif

  Serial.printf("CMD: unknown '%s'\n", cmd.c_str());
}

static void pollSerialCommands() {
  while (Serial.available() > 0) {
    char c = (char)Serial.read();
    if (c == '\r') continue;
    Serial.write(c);
    if (c == '\n') {
      Serial.println();
      handleSerialCommand(g_serialCmdLine);
      g_serialCmdLine = "";
    } else if (g_serialCmdLine.length() < 160) {
      g_serialCmdLine += c;
    }
  }
}


// TIME
static void initTimeUTC() {
  configTime(0, 0, "pool.ntp.org", "time.nist.gov");
  Serial.print("NTP: syncing");
  for (int i = 0; i < 40; ++i) {
    if (time(nullptr) > 1600000000) { Serial.println("\nNTP OK"); return; }
    Serial.print(".");
    delay(250);
  }
  Serial.println("\nNTP: failed (will still try).");
}
static uint32_t minuteEpoch(time_t now) { return (uint32_t)((now / 60) * 60); }

// HARD RX RESET
static void resetRadioForRx() {
  lora->standby();
  delay(5);

  lora->begin(loraFreqMHz());
  lora->setDio2AsRfSwitch(true);
  lora->setSyncWord(0x34);
  lora->setBandwidth(125.0);
  lora->setSpreadingFactor(9);
  lora->setCodingRate(5);
  lora->setRxBoostedGainMode(true);
  lora->setCRC(true);
  lora->setOutputPower(LORA_TX_POWER);


  lora->startReceive();
}

// HTTP POST
static int postOnce(const String& body) {
  if (WiFi.status() != WL_CONNECTED) return -1;

  WiFiClientSecure client;
  client.setInsecure();

  HTTPClient http;
  http.setFollowRedirects(HTTPC_FORCE_FOLLOW_REDIRECTS);
  http.useHTTP10(true);
  http.setReuse(false);
  http.setTimeout(15000);

  String url = String(POST_BASE) + "?api_key=" + API_KEY;
  if (!http.begin(client, url)) return -1;

  http.addHeader("Content-Type", "application/x-www-form-urlencoded");
  http.addHeader("Accept", "*/*");
  http.addHeader("User-Agent", "curl/8.0.1");
  http.addHeader("Accept-Encoding", "identity");
  http.addHeader("Connection", "close");

  Serial.printf("POST %s\nBODY: %s\n", url.c_str(), body.c_str());

  int code = http.POST(body);
  String resp = http.getString();
  http.end();

  // Only log real problems: network/<0>, timeout 408, 5xx, and non-400 client errors
  if (code < 0 || code == 408 || (code >= 500 && code < 600) || (code >= 400 && code < 500 && code != 400)) {
    Serial.printf("HTTP %d\n", code);
    if (code >= 500) {
      Serial.println(resp);
    }
  }

  return code;
}


// OPTIONAL: TEST POSTER
#ifdef LAB_MODE
static const bool ENABLE_TEST_POSTS = false;
#else
static const bool ENABLE_TEST_POSTS = false;
#endif
static uint32_t    g_lastTestMinute = 0;
static uint32_t    g_testCnt        = 0;

static void maybeSendTestPacket() {
  if (!ENABLE_TEST_POSTS) return;
  time_t now = time(nullptr);
  if (now < 1600000000) return;

  uint32_t mt = minuteEpoch(now);
  if (mt == g_lastTestMinute) return;
  g_lastTestMinute = mt;

  static int k = 0; k = (k + 1) % 12;
  float wind_avg = 10.0f + 0.5f * k;
  float wind_max = wind_avg * 1.5f;
  int   wind_dir = 200 + 5 * k;
  uint32_t cnt = ++g_testCnt;

  char buf[128];
  snprintf(buf, sizeof(buf),
           "wind_avg=%.1f&wind_max=%.1f&wind_dir=%d&cnt=%lu",
           wind_avg, wind_max, wind_dir, (unsigned long)cnt);
  String body(buf);

  Serial.printf("TEST POSTING: %s\n", body.c_str());
  int code = postOnce(body);

  bool transient = (code < 0) || code == 408 || (code >= 500 && code < 600);
  if (transient) {
    Serial.printf("TEST transient (code=%d), retrying once...\n", code);
    delay(1200);
    code = postOnce(body);
  } else if (code >= 400 && code < 500) {
    Serial.printf("TEST client error (%d), skipping retry\n", code);
  }

  if (code == 200 || code == 201) {
    Serial.println("TEST POST accepted (200/201)");
  } else if (code == 400) {
    Serial.println("TEST POST accepted (benign 400)");
  } else {
    Serial.printf("TEST POST not successful (code=%d)\n", code);
  }
}

// === ACK SUPPORT ===
static void sendAck(uint32_t cnt, const char* status) {
  char head[64];
  snprintf(head, sizeof(head), "ACK %lu %s", (unsigned long)cnt, status);
  uint16_t crc = crc16_ccitt((const uint8_t*)head, strnlen(head, sizeof(head)));
  char frame[80];
  snprintf(frame, sizeof(frame), "%s*%04X", head, (unsigned)crc);
  String s(frame);
  lora->standby();
  int st = lora->transmit(s);
  Serial.printf("BASE: ACK TX (%s) state=%d\n", frame, st);
  resetRadioForRx();
}

// SETUP
void setup() {
  Serial.begin(115200);
  delay(300);

#ifdef ENV_LAB

  Serial.println("[ENV] LAB mode");
#elif defined(ENV_FIELD)
  Serial.println("[ENV] FIELD mode");
#else
  Serial.println("[ENV] UNKNOWN mode - no ENV_* macro set");
#endif
  Serial.print("LORA_FREQ = ");
  Serial.println((unsigned long)LORA_FREQ);
  Serial.print("LORA_TX_POWER = ");
  Serial.println(LORA_TX_POWER);

#ifdef LAB_MODE
  Serial.println("[SCRIPT] LAB_MODE active – posting to TEST sheet endpoint");
#else
  Serial.println("[SCRIPT] LAB_MODE not set – posting to PROD 'Pearl' sheet endpoint");
#endif
  Serial.print("POST_BASE = ");
  Serial.println(POST_BASE);
  Serial.print("API_KEY = ");
  Serial.println(API_KEY);

  pinMode(LED_HEARTBEAT, OUTPUT);
  digitalWrite(LED_HEARTBEAT, LOW);

  // Optional: boot test – three quick blinks so we know pin 35 is really the LED
  for (int i = 0; i < 3; ++i) {
    digitalWrite(LED_HEARTBEAT, HIGH);
    delay(150);
    digitalWrite(LED_HEARTBEAT, LOW);
    delay(150);
  }

  connectWiFi(15000);
  initTimeUTC();
  g_start_ms = millis();

  Serial.println("LittleFS: mounting...");
  #ifdef LAB_MODE
  bool ok = LittleFS.begin(true);
  #else
  bool ok = LittleFS.begin(true);
  #endif
  if (ok) {
    g_bufferEnabled = true;
    Serial.println("LittleFS: mounted");
    initBufferState();
    g_lastCntPosted = g_lastUploadedCnt;
  } else {
    g_bufferEnabled = false;
    Serial.println("LittleFS: mount failed, buffering disabled");
  }

  SPI.begin(PIN_SCK, PIN_MISO, PIN_MOSI, PIN_NSS);
  modPtr = new Module(PIN_NSS, PIN_DIO1, PIN_RST, PIN_BUSY);
  lora   = new SX1262(modPtr);

  int st = lora->begin(loraFreqMHz());
  Serial.print("BASE begin()-> "); Serial.println(st);
  if (st != RADIOLIB_ERR_NONE) {
    Serial.println("LoRa init failed");
    while (true) delay(1000);
  }

  lora->setDio2AsRfSwitch(true);
  lora->setSyncWord(0x34);
  lora->setBandwidth(125.0);
  lora->setSpreadingFactor(9);
  lora->setCodingRate(5);
  lora->setRxBoostedGainMode(true);
  lora->setCRC(true);
  lora->setOutputPower(LORA_TX_POWER);

  lora->startReceive();

#ifdef HAS_DISPLAY
  DisplayUI::begin();
#endif

  Serial.println("BASE: ready (listening)");
}

      // LOOP
    void loop() {
      uint32_t now = millis();
      pollSerialCommands();

#ifdef HAS_DISPLAY
      DisplayUI::loop();
#endif

      // If we've heard a packet recently, show solid ON so it's easy to see during range tests
      if (now < g_rxHoldUntilMs) {
        digitalWrite(LED_HEARTBEAT, HIGH);
      } else {
        // Otherwise keep it off (heartbeat wink removed)
        digitalWrite(LED_HEARTBEAT, LOW);
      }


      if (lora->getPacketLength() != 0) {
        String payload;
        int st = lora->readData(payload);

      if (st == RADIOLIB_ERR_NONE) {

      payload.trim();
      if (payload.length() == 0) {
        Serial.println("BASE: empty payload, skip");
        resetRadioForRx();
        delay(20);
        return;
      }

      if (payload[0] != '{') {
        Serial.println("Packet does not start with '{' - skipping");
        resetRadioForRx();
        delay(20);
        return;
      }

      // RF duplicate burst guard
      const uint32_t RF_DUP_MS = 5000UL;
      if (payload == g_lastRx && (millis() - g_lastRxMs) < RF_DUP_MS) {
        g_dupCount++;
        g_rf_dup++;   // count cumulative RF dups
        if (millis() - g_dupLastLog > 20000UL) {
          Serial.printf("BASE: duplicate RF payload burst (+%u skipped)\n", g_dupCount);
          g_dupLastLog = millis();
          g_dupCount   = 0;
        }
        resetRadioForRx();
        delay(20);
        return;
      }
      if (g_dupCount > 0) {
        Serial.printf("BASE: duplicate burst ended (total skipped=%u)\n", g_dupCount);
        g_dupCount = 0;
      }
      g_lastRx   = payload;
      g_lastRxMs = millis();

      // CRC16 verify
      Serial.printf("RAW PAYLOAD: %s\n", payload.c_str());
      int starIdx = payload.lastIndexOf('*');
      if (starIdx < 0 || (payload.length() - starIdx - 1) < 4) {
        Serial.println("CRC trailer missing/short; dropping packet");
        // no ACK on CRC fail
        resetRadioForRx(); delay(20); return;
      }

      char hex4[5];
      hex4[0] = payload[starIdx + 1];
      hex4[1] = payload[starIdx + 2];
      hex4[2] = payload[starIdx + 3];
      hex4[3] = payload[starIdx + 4];
      hex4[4] = '\0';

      for (int i = 0; i < 4; ++i) {
        if (!isxdigit((unsigned char)hex4[i])) {
          Serial.println("CRC trailer not hex; dropping packet");
          // no ACK on CRC fail
          resetRadioForRx(); delay(20); return;
        }
      }

      unsigned rx_crc_u = 0;
      sscanf(hex4, "%04X", &rx_crc_u);
      uint16_t rx_crc = (uint16_t)rx_crc_u;

      String jsonPart = payload.substring(0, starIdx);
      uint16_t calc = crc16_ccitt((const uint8_t*)jsonPart.c_str(), jsonPart.length());
      if (calc != rx_crc) {
        g_crc_fail++;   // count failures
        Serial.printf("CRC mismatch: calc=%04X rx=%04X -> drop\n", (unsigned)calc, (unsigned)rx_crc);
        // no ACK on CRC fail
        resetRadioForRx(); delay(20); return;
      }

      payload = jsonPart;
      g_crc_ok++;       // count passes

      // Parse JSON
      StaticJsonDocument<256> d;
      DeserializationError err = deserializeJson(d, payload);
      if (err) {
        Serial.println("Parse fail: bad JSON, skipping this packet");
        // no ACK on malformed JSON
        resetRadioForRx(); delay(20); return;
      }

      float wind_avg = d["wind_avg"] | 0.0f;
      float wind_max = d["wind_max"] | 0.0f;
      int   wind_dir = d["wind_dir"] | 0;
      long  cntJ     = d["cnt"]      | -1;
      float batt_v   = d["batt"]     | -1.0f;

      Serial.printf("PARSED: wind_avg=%.1f wind_max=%.1f wind_dir=%d cnt=%ld batt=%.2f\n",wind_avg, wind_max, wind_dir, cntJ, batt_v);

      if (wind_avg == 0.0f && wind_max == 0.0f && wind_dir == 0) {
        Serial.println("Packet looked valid but values are all zero; skipping as corrupted");
        // no ACK on clearly corrupt content
        resetRadioForRx(); delay(20); return;
      }

#ifdef HAS_DISPLAY
      DisplayUI::notifyRx();
#endif

      // Range-test indicator: keep LED solid for a while after a valid packet
      g_rxHoldUntilMs = millis() + 10000UL;   // LED solid ON for ~10 seconds
      Serial.printf("RX: hold LED until %lu\n", (unsigned long)g_rxHoldUntilMs);

      float rssi_f = lora->getRSSI();
      float snr_f  = lora->getSNR();
      int32_t cnt  = (int32_t)cntJ;
      if (cnt >= 0) g_latestCntReceived = cnt;

      // === EARLY ACK (send immediately after valid parse) ===
      if (cnt >= 0) {
        sendAck((uint32_t)cnt, "OK");
      }

      // ----- DROPPED PACKET ESTIMATE (based on Pearl per-packet cnt) -----
      int32_t drop_gap = 0;

      if (cnt >= 0) {
        if (g_lastCntAccepted >= 0) {
          int32_t delta = cnt - g_lastCntAccepted;

          if (delta > 0) {
            drop_gap = delta - 1;  // expect +1 per data packet
            if (drop_gap < 0) drop_gap = 0;
            g_drop_total += (uint32_t)drop_gap;
          }
        }
        g_lastCntAccepted = cnt;
      }

      // Build body (with health + drop stats)
      uint32_t uptime_s = (millis() - g_start_ms) / 1000UL;
      uint32_t delivered_next = g_delivered_total + 1; // counting this one

      char buf[420];
      snprintf(buf, sizeof(buf),
               "wind_avg=%.1f&wind_max=%.1f&wind_dir=%d"
               "&cnt=%ld&batt=%.2f&rssi=%.1f&snr=%.1f"
               "&crc_ok=%lu&crc_fail=%lu&rf_dup=%lu&uptime_s=%lu",
               wind_avg, wind_max, wind_dir,
               (long)cnt, batt_v, rssi_f, snr_f,
               (unsigned long)g_crc_ok, (unsigned long)g_crc_fail, (unsigned long)g_rf_dup,
               (unsigned long)uptime_s);

      String body(buf);
      Serial.printf("BODY (clean): %s\n", body.c_str());

      appendBufferRecord(wind_avg, wind_max, wind_dir, cnt, batt_v, rssi_f, snr_f, uptime_s);

      // in-flight / dedupe / rate limit
      if (cnt >= 0 && g_inflightCnt == cnt && (millis() - g_inflightMs) < INFLIGHT_GUARD_MS) {
        Serial.println("BASE: in-flight guard (same cnt), skip");
        sendAck((uint32_t)cnt, "DUP");
        resetRadioForRx(); delay(20); return;
      }
      if (cnt >= 0 && cnt == g_lastCntPosted) {
        Serial.println("BASE: duplicate by cnt, skip");
        sendAck((uint32_t)cnt, "DUP");
        resetRadioForRx(); delay(20); return;
      }
      if ((millis() - g_lastPostMs) < MIN_POST_MS) {
        Serial.println("BASE: rate-limit active, skip post");
        sendAck((uint32_t)cnt, "RATE");
        resetRadioForRx(); delay(20); return;
      }
      const uint32_t HTTP_DUP_MS = 70000UL;
      if (body == g_lastBody && (millis() - g_lastPostMs) < HTTP_DUP_MS) {
        Serial.println("BASE: duplicate body within window, skip");
        sendAck((uint32_t)cnt, "DUP");
        resetRadioForRx(); delay(20); return;
      }

      if (WiFi.status() != WL_CONNECTED) {
        connectWiFi(2000);   // quick attempt to reconnect, then move on
      }


      lora->standby();
      g_inflightCnt = cnt;
      g_inflightMs  = millis();

      Serial.printf("BASE POSTING (rssi=%.1f, snr=%.1f): %s\n", rssi_f, snr_f, body.c_str());

      int code = postOnce(body);

      // retry only on transient server/network errors
      bool transient = (code < 0) || code == 408 || (code >= 500 && code < 600);
      if (transient) {
        Serial.printf("POST transient (code=%d), retrying once...\n", code);
        delay(1200);
        code = postOnce(body);

      // silence benign 400; still log other 4xx
      } else if (code >= 400 && code < 500 && code != 400) {
        Serial.printf("Client error (%d), skipping retry\n", code);
      }

      if (code == 200 || code == 201 || code == 400) {
        g_lastBody   = body;
        g_lastPostMs = millis();
        if (cnt >= 0) {
          g_lastCntPosted = cnt;
          setLastUploadedCnt(cnt);
        }
        g_delivered_total++;     // <-- count delivered rows for rate calc
#ifdef HAS_DISPLAY
        DisplayUI::notifyPost(true);
#endif
        if (cnt >= 0) sendAck((uint32_t)cnt, "OK");
      } else {
        Serial.printf("POST not successful (code=%d)\n", code);
#ifdef HAS_DISPLAY
        DisplayUI::notifyPost(false);
#endif
        // treat as transient → no ACK so Pearl may retry
      }

      resetRadioForRx();
      if ((millis() - g_inflightMs) >= INFLIGHT_GUARD_MS) g_inflightCnt = -1;

    } else {
      Serial.printf("BASE RX error: %d\n", st);
      resetRadioForRx();
    }
  }

  maybeSendTestPacket();
  delay(20);
}


// handy:

// pio run -e base_field_v4 -t upload --upload-port /dev/cu.usbmodem1301

// pio run -e base_lab_v4 -t upload --upload-port /dev/cu.usbmodem1301

// pio device monitor -p /dev/cu.usbmodem1301 -b 115200
