jayriihi/WeatherStations/(commit log)

2025-10-24 made variables match sheet beginning to end, encapsulated pearl packet in json, set delays between reception in base to avoid bursts. close but getting hung on the initial cnt and not advancing
    [main.cpp]
2025-10-28 Changed test data simulator to emulate seril port data coming off of Windsonic and comvert m/s to knots
2025-11-06 Added check sum and packet quality control to print on sheet. Apps script updated to receive also
2025-11-06 Silence benign 400s; keep retry on transients. Post QC fields; CRC+RF dup counters wired
2025-11-15 Adjusted leds for field testing
2025-11-15 adjustedd output power for fieldtesting
2025-11-18 Corrected the wifi settings to enable logon to jays hotspot and Spank's House
    [main.cpp]
2025-12-06 Added LAB env vs Field for testing tightened up the ACK timing
    [Config.h, main.cpp]
2025-12-12 Added battery logic to firmware
2025-12-12 Added led screen status and sign of life scroll to base station
2025-12-15 Took out the beating heart LED now we have spinner it is unneccesary
2026-01-09 cranked the power up to 14 for deployment on the island
2026-02-12 established file buffering on base_station to store data in the event of an outage
    [partitions_base.csv]
2026-09-08 Fix Base V4 LittleFS mounting and add offline data recovery instructions
    [main.cpp]
2026-09-10 Add Pearl V4 heartbeat and recalibrate battery sensing
2026-09-11 Add V4 heartbeat and finalize battery voltage sensing
2026-10-02 Stabilize Pearl V4 WindSonic input
    [pearl_v2_bom.csv, pearl_v2_final.sch, pearl_v2_schematic.kicad_sch]
2026-10-02 Ignore local KiCad files and generator repo
2026-10-04 Add provisional Pearl V2 assembly layout
    [hole_coordinates.csv, pearl_v2_assembly_connections.kicad_sch, pearl_v2_assembly_wiring.kicad_sch]
